artema0g/Si5351-RF-Generator/(commit log)

2026-09-01 docs: add graphical hardware wiring diagram and update README
2026-09-01 docs: upgrade wiring diagram with high-precision schematics and 3D breadboard layout
2026-09-01 docs: update hardware wiring diagram to clean breadboard layout
2026-09-01 docs: simplify wiring section in README
2026-09-01 docs: add detailed guidance on NEO-6M PPS/TIMEPULSE pin location and logic levels
2026-09-02 fix: rename sketch file to Gen_Si5351.ino to eliminate spaces
    [Gen_Si5351.ino]
2026-09-02 docs: add real lab scope verification and CLI line-ending fix
    [cli_commands.cpp]
