artema0g/Si5351-RF-Generator/(notices)

Notices in the files:
README.md:
License: MIT
